roboime/SSL_Electronic_Boards/Kicker_Module_2016/Project Outputs for kicker_driver00/BOM1.xls

Name | Description | Designator | Quantity | LibRef | Manufacturer 1 | Manufacturer Part Number 1 | Manufacturer Lifecycle 1 | Supplier 1 | Supplier Part Number 1 | Supplier Unit Price 1 | Supplier Subtotal 1 | Supplier Currency 1 | Supplier Order Qty 1 | Supplier Stock 1 | Supplier Subtotal per Board 1
CGA9P4X7T2W105M250KE | 1µF 450V Ceramic Capacitor X7T 2220 (5750 Metric) 0.224" L x 0.197" W (5.70mm x 5.00mm) | BoostC1 | 1.0 | Cap 1UF 2220 450V | TDK Corporation | CGA9P4X7T2W105M250KE | Manual Solution | Digi-Key | 445-7998-1-ND | 3.08 | 3.08 | USD | 1.0 | 16579.0 | 3.08
MURS360BT3G | Surface Mount Ultrafast Power Rectifier, 2-Pin SMB, Pb-Free, Tape and Reel | BoostD1, P4D1, P5D1 | 3.0 | CMP-0902-00327-1 | Falha catastrófica | MURS360BT3G | Manual Solution | Digi-Key | MURS360BT3GOSCT-ND | 0.41 | 1.23 | USD | 3.0 | 64572.0 | 1.23
GRM155R71H102KA01D | 1000pF 50V Ceramic Capacitor X7R 0402 (1005 Metric) 0.039" L x 0.020" W (1.00mm x 0.50mm) | ConC1 | 1.0 | Cap 1nF 0402 | Falha catastrófica | GRM155R71H102KA01D | Manual Solution | Digi-Key | 490-1303-1-ND | 0.1 | 0.1 | USD | 1.0 | 5219427.0 | 0.1
MC34063ACD | Buck, Boost Switching Regulator IC Positive or Negative Adjustable 1.25V 1 Output 1.5A (Switch) 8-SOIC (0.154", 3.90mm Width) | ConIC1 | 1.0 | MC34063ACD | STMicroelectronics | MC34063ACD-TR | Manual Solution | Digi-Key | 497-7850-1-ND | 0.57 | 0.57 | USD | 1.0 | 35351.0 | 0.57
CRA2512-FZ-R100ELF | RES SMD 0.1 OHM 1% 3W 2512 | ConR1 | 1.0 | RES 0R1 2512 | Falha catastrófica | CRA2512-FZ-R100ELF | Manual Solution | Digi-Key | CRA2512-FZ-R100ELFCT-ND | 0.6 | 0.6 | USD | 1.0 | 60102.0 | 0.6
RC1206JR-073K3L | RES SMD 3.3K OHM 5% 1/4W 1206 | ConR2 | 1.0 | RES 3.3K 1206 |  |  |  |  |  | 0.0 | 0.0 |  | 0.0 | 0.0 | 0.0
RC1206FR-07470KL | RES SMD 470K OHM 1% 1/4W 1206 | ConR3 | 1.0 | RES 470K 1206 |  |  |  |  |  | 0.0 | 0.0 |  | 0.0 | 0.0 | 0.0
RC0402JR-0747RL | RES SMD 47 OHM 5% 1/16W 0402 | ConR4 | 1.0 | RES 47 0402 |  |  |  |  |  | 0.0 | 0.0 |  | 0.0 | 0.0 | 0.0
RC0402JR-071KL | RES SMD 1K OHM 5% 1/16W 0402 | ConR5 | 1.0 | RES 1K 0402 |  |  |  |  |  | 0.0 | 0.0 |  | 0.0 | 0.0 | 0.0
C4532X7R2E474K230KA | 0.47µF 250V Ceramic Capacitor X7R 1812 (4532 Metric) 0.177" L x 0.126" W (4.50mm x 3.20mm) | KickC1, KickC2 | 2.0 | Cap 470nF 250V 1812 | TDK Corporation | C4532X7R2E474K230KA | Manual Solution | Digi-Key | 445-2299-1-ND | 0.88 | 1.76 | USD | 2.0 | 47529.0 | 1.76
GRM155R71C104KA88D | 0.10µF 16V Ceramic Capacitor X7R 0402 (1005 Metric) 0.039" L x 0.020" W (1.00mm x 0.50mm) | KickC3, SwC1 | 2.0 | Cap 100nF 0402 | Murata Electronics North America | GRM155R71C104KA88D | Manual Solution | Digi-Key | 490-3261-1-ND | 0.012 | 0.12 | USD | 10.0 | 22343893.0 | 0.024
T491A475M025AT | 4.7µF Molded Tantalum Capacitors 25V 1206 (3216 Metric) 6 Ohm 0.126" L x 0.063" W (3.20mm x 1.60mm) | KickC4, SwC2 | 2.0 | Cap Tant 4,7UF 1206 | Kemet | T491A475M025AT | Manual Solution | Digi-Key | 399-4630-1-ND | 0.43 | 0.86 | USD | 2.0 | 215543.0 | 0.86
IR4427STRPBF | IC DRIVER DUAL LOW SIDE 8SOIC | KickIC1, SwIC1 | 2.0 | IR4427 | Infineon Technologies | IR4427STRPBF | Manual Solution | Digi-Key | IR4427SPBFCT-ND | 1.36 | 2.72 | USD | 2.0 | 41582.0 | 2.72
IRFP4768PbF | MOSFET N-CH 250V 93A TO-247AC | KickQ1, KickQ2 | 2.0 | IRG4PC50FD |  |  |  |  |  | 0.0 | 0.0 |  | 0.0 | 0.0 | 0.0
RC0402JR-0710RL | RES SMD 10 OHM 5% 1/16W 0402 | KickR1, KickR3, SwR1, SwR3 | 4.0 | RES 10 0402 | Yageo | RC0402JR-0710RL | Manual Solution | Digi-Key | 311-10JRCT-ND | 0.012 | 0.12 | USD | 10.0 | 542048.0 | 0.048
PF1206FRF070R02L | RES SMD 0.02 OHM 1% 1/4W 1206 | KickR2, KickR4, SwR2 | 3.0 | RES 0R02 1206 | Yageo | PF1206FRF070R02L | Manual Solution | Digi-Key | 311-0.02AJCT-ND | 0.52 | 1.56 | USD | 3.0 | 94479.0 | 1.56
Header 12 | Header, 12-Pin | P1, P2 | 2.0 | Header 12 |  |  |  |  |  | 0.0 | 0.0 |  | 0.0 | 0.0 | 0.0
EEE-FK1C681GP | Aluminum Electrolytic Capacitors - SMD Al Lytic Cap SMT FK Series 105C | P2C1 | 1.0 | CAP AL 680UF/16V | Panasonic Electronic Components | EEE-FK1C681GP | Manual Solution | Digi-Key | PCE4316CT-ND | 1.2 | 1.2 | USD | 1.0 | 2997.0 | 1.2
MF-MSMF250/16X-2 | PTC RESETTABLE | P2F1 | 1.0 | MF-MSMF250/16X | Bourns Inc. | MF-MSMF250/16X-2 | Manual Solution | Digi-Key | MF-MSMF250/16X-2CT-ND | 0.77 | 0.77 | USD | 1.0 | 27980.0 | 0.77
OSTTA024163 | 2 Position Wire to Board Terminal Block Horizontal with Board 0.200" (5.08mm) Through Hole | P3, P4, P5 | 3.0 | Term Block 2P |  |  |  |  |  | 0.0 | 0.0 |  | 0.0 | 0.0 | 0.0
SRF1280-100M | Shielded 2 Coil Inductor Array 40µH Inductance - Connected in Series 10µH Inductance - Connected in Parallel 24.1 mOhm Max DC Resistance (DCR) - Parallel 6.04A Nonstandard | SRF1280 | 1.0 | SRF1280-100M | Falha catastrófica | SRF1280-100M | Manual Solution | Digi-Key | SRF1280-100MCT-ND | 1.5 | 1.5 | USD | 1.0 | 617.0 | 1.5
C1206C474K5NACTU | 0.47µF 50V Ceramic Capacitor X8L 1206 (3216 Metric) 0.126" L x 0.063" W (3.20mm x 1.60mm) | SwC3 | 1.0 | Cap 470nF 50V 1206 | Kemet | C1206C474K5NACTU | Manual Solution | Digi-Key | 399-5732-1-ND | 0.34 | 0.34 | USD | 1.0 | 125040.0 | 0.34
MMSZ18T1G | Zener Voltage Regulator, 500 mW, 2-Pin SOD-123, Pb-Free, Tape and Reel | SwD1 | 1.0 | CMP-1060-00279-1 | ON Semiconductor | SZMMSZ18T1G | Manual Solution | Digi-Key | SZMMSZ18T1GOSCT-ND | 0.38 | 0.38 | USD | 1.0 | 2900.0 | 0.38
SUM45N25-58-E3 | MOSFET N-CH 250V 45A D2PAK | SwQ1 | 1.0 | SUM45N25 | Vishay Siliconix | SUM45N25-58-E3 | Manual Solution | Digi-Key | SUM45N25-58-E3CT-ND | 3.27 | 3.27 | USD | 1.0 | 6484.0 | 3.27
