roboime/SSL_Electronic_Boards/Motor_Driver_2018/Project Outputs for Motor_Driver_2018/Motor_Driver_2018PCB.xls

Comment | Description | Designator | Footprint | LibRef | Quantity
100nF | CAP CER 0.1UF 50V 10% X7R 0402 | C1, C6 | 0402-CAP | CC0402-100nF-50v-A.3 | 2.0
33nF | CAP CER 0.033UF 25V 10% X7R 0402 | C2, C5 | 0402-CAP | CC0402-33nF-5 | 2.0
220nF | CAP CER 0.22UF 16V 10% X7R 0402 | C3, C4 | 0402-CAP | CC0402-220nF-5 | 2.0
10uF | CAP TANT 10uF 10% 16V CASE A ESR = 3 Ohm @ 100 kHz | C7 | 1206_CAP_TANT | CT3216-10uF-1 | 1.0
22032041 | CONN HEADER 4POS .100 VERT TIN | CON-MC1, CON-MC2 | 04X01_CONECTOR_MALE | 04x01_Conector_Male-SCH | 2.0
PWD13F60 | High Voltage Full Bridge | IC? | QFN50P1000X1300X85_HS-61N | PWD13F60_1-01.A.8 | 1.0
