roboime/SSL_Electronic_Boards/Kicker_Module_2018/Project Outputs for Kicker_Module_2018/Kicker2018_PCB.xls

Comment | Description | Designator | Footprint | LibRef | Quantity
BAS40 Diode |  | BAS40, D6 | DIODE SOD-523 | BAS40 Diode | 2.0
10uF | CAP CER 10UF 16V X5R 0603 | C1, C2, C3 | CAPC0603(1608)55_L | C0603-10uF-16V-1 | 3.0
100pF | CAP CER 100PF 50V NP0 0603 | C4 | CAPC0603(1608)55_L | CC0603--1 | 1.0
100uF | CAP TANT 100uF 25V 20% ESR = 30mOhm @ 100 kHz | C5, C7, C9 | 7343-CAPPOL | CT2917-100uF-1 | 3.0
22uF |  | C6 | CAP ALUM 22UF 250V | CAP ALUM 22UF 250V | 1.0
180pF | CAP CER 180PF 50V NP0 0805 | C8 | 0805-CAP | CC0805-180pF-2 | 1.0
CHARGE_ENABLE | Single-Pole, Single-Throw Switch | CE | TACTILE SWITCH | SW-SPST | 1.0
OSTTA024163 | 2 Position Wire to Board Terminal Block Horizontal with Board 0.200" (5.08mm) Through Hole | CON_CAP, CON_CHIP_KICK, CON_KICK | TERM BLOCK 2P | Term Block 2P | 3.0
ES3J |  | D1, D2, D3 | DIODE | ES3J | 3.0
PMEG30 | DIODE SCHOTTKY 30V 5A SOD128 | D4 | PCBComponent | PMEG3050EP,115-01.A.5 | 1.0
GATE DRIVER | IC DRIVER DUAL LOW SIDE 8-SOIC | IR4427 | IR4427 | IR4427 | 1.0
100uH | Fixed Inductors 100uH 0.86A SMT | L1 | INDUCTOR | Inductor | 1.0
DA2034 Transformer |  | L2 | DA2034 TRANSFORMER | DA2034 Transformer | 1.0
Flyback Regulator |  | LT3750 | LT3750 | LT3750 | 1.0
Switching Voltage Regulator | Switching Voltage Regulator | MC34063 | MC34063 | MC34063 | 1.0
Header 12 | Header, 12-Pin | P1, P2 | HDR1X12 | Header 12 | 2.0
CSD1854 | MOSFET N-CH 60V 100A 8VSON | Q1 | PCBComponent | CSD18540Q5BT-1 | 1.0
IRG4PC50FD | IGBT Transistors 600V FAST 1-8 KHZ COPACK IGBT | Q2, Q3 | IRG4PC50FD | IRG4PC50FD | 2.0
100K | RES 100K OHM 1/10W 1% 0402 SMD 1 | R1 | 0402-RES-HD | R0402-100K-11 | 1.0
33K | RES 33K OHM 1/10W 1% 0402 SMD | R2 | 0402-RES-HD | R0402-33K-7 | 1.0
42K2 | RES 42.2K OHM 1/10W 1% 0402 SMD | R3 | 0402-RES-HD | RESISTOR | 1.0
2K2 | RES 2.2K OHM 1/10W 1% 0402 SMD | R4 | 0402-RES-HD | R0402-2K2-5 | 1.0
15m | Resistor | R5 | RES1206 | Res2 | 1.0
10R | RES 10 OHM 1/10W 1% 0402 SMD | R6, R7 | 0402-RES-HD | R0402-10R-6 | 2.0
1R | RES SMD 1 OHM 1% 1/8W 0805 | R8 | 0805-RES | R0805-1R-1%-1 | 1.0
160R | RES 160 OHM 1/8W .5% 0805 SMD | R9 | 0805-RES | R0805-160R-5 | 1.0
1K | RES 1K OHM 1/10W 1% 0402 SMD | R10, R12 | 0402-RES-HD | R0402-1K-A.9 | 2.0
11K1 | RES 11.1 KOHM 1/16W 0.1% 0402 SMD | R11 | 0402-RES-HD | R0402-11K1-1 | 1.0
KICK | Single-Pole, Single-Throw Switch | S1 | TACTILE SWITCH | SW-SPST | 1.0
