roboime/SSL_Electronic_Boards/Mother_Board_2018/Project Outputs for Mother_Board_SSL2018/Mother_board_SSL2018.xls

Comment | Description | Designator | Footprint | LibRef | Quantity
MOTOR 0 | CONN HEADER 6POS .100 VERT GOLD | 06x01_Conector_Male_M0 | 06x01_Conector_Male | 06x01_Conector_Male | 1.0
MOTOR 3 | CONN HEADER 6POS .100 VERT GOLD | 06x01_Conector_Male_M1 | 06x01_Conector_Male | 06x01_Conector_Male | 1.0
MOTOR 1 | CONN HEADER 6POS .100 VERT GOLD | 06x01_Conector_Male_M2 | 06x01_Conector_Male | 06x01_Conector_Male | 1.0
MOTOR 2 | CONN HEADER 6POS .100 VERT GOLD | 06x01_Conector_Male_M3 | 06x01_Conector_Male | 06x01_Conector_Male | 1.0
XT60 | XT60 PRT-10474 | BAT | BATTERY_CONECTO-PCB | BATTERY_CONNECTOR | 1.0
100nF | CAP CER 0.1UF 50V 10% X7R 0402, CAP CER 0.1UF 10V 20% X5R 0402 | C1, C5, C6, MC_C1, MC_C2, MC_C3, MC_C4, MC_C5, NRF_C1 | 0402-CAP | CC0402-100nF-50v-A.3, CC0402-100nF-A.12 | 9.0
22uF | CAP CER 22UF 6.3V 20% X5R 1206 | C2, C3 | 1206-CAP | CC1206-22uF-6.3V-1 | 2.0
10uF | CAP CER 10UF 50V 20% X5R 1210 | C4 | 1210-CAP | CC1210-10uF-6 | 1.0
1uF | CAP CER 1UF 6.3V 10% X5R 0402 | C7 | 0402-CAP | CC0402-1uF-5 | 1.0
CAP_TANQUE | Aluminum Electrolytic Capacitors - SMD Al Lytic Cap SMT FK Series 105C | CD, CM1_M2, CM1_M3 | EEE-FK1C681GP | CAP AL 680UF/16V | 3.0
CAP-TANQUE | Aluminum Electrolytic Capacitors - SMD Al Lytic Cap SMT FK Series 105C | CM1_M0, CM1_M1 | EEE-FK1C681GP | CAP AL 680UF/16V | 2.0
DRIBLE | CONN HEADER 2POS .100 VERT GOLD | CON_DRIBLE | 02x01_Conector_Male | 02x01_Conector_Male | 1.0
MF-MSMF | PTC RESETTABLE .30A 30V 1812 | DF, FM_M0, FM_M1, FM_M2, FM_M3 | RESC4632X16N | MF-MSMF250/16X-01.A.1 | 5.0
SFH11-PBPC-D25-ST-BK | 50 Position Header Connector 0.100" (2.54mm) Through Hole Gold | DISCO_P1, DISCO_P2 | 25x02_Conector_Female | 25x02_Conector_Female | 2.0
HDSP-F513 | 7 segments display | Display | New footprint 1 | HDSP-F513-01.A.2 | 1.0
PPPC041LFBN-RC | 4 Position Header Connector 0.100" (2.54mm) Through Hole Gold | DRIBLE-MC, DRIBLE-MOTOR | 04x01_Conector_Female - duplicate | 04x01_Conector_Female-SCH | 2.0
TPS5632 | IC REG BUCK ADJ 3A SYNC 6SOT | IC1 | SOT95P280X110-6N | TPS563200DDCT-01.A.2 | 1.0
MPU-9250 | IMU ACCEL/GYRO/MAG I2C/SPI 24QFN | IC3 | MPU-9250 | MPU-9250-1 | 1.0
STMPE811 | IC TSC I/O EXPAND 8B 16QFN | IC4 | QFN16_N | STMPE811QTR-6 | 1.0
SWITCH TACTILE 6 x 3.5 x 4.3 mm | GRAYHILL TACT,GW,6X3.5,1800T&R,LF Eight, 160g Operating Force, Gull Wing, RoHS Compliant | ID | PCBComponent | 95C04A3GWRT.-1 | 1.0
INA169 | IC CURRENT MONITOR 0.5% SOT23-5 | INA169, INA169_M0, INA169_M1, INA169_M2, INA169_M3 | SOT95P280X125-5N | INA169NA-01.A.1 | 5.0
JS202011SCQN | SWITCH SLIDE DPDT 300MA 6V | KICK | SOP250P750X350-6N | JS202011SCQN-1 | 1.0
CLF7045T | FIXED IND 4.7UH 4.1A 20 MOHM SMD | L1 | CLF7045T | CLF7045T-4R7N-H-2 | 1.0
LD1117S33CTR | Fixed Low Drop Positive Voltage Regulator, 3.3V, 4-Pin SOT-223, Tape and Reel | LD1117 | SOT-223_N | CMP-0244-00307-1 | 1.0
0022112022 | CONN HEADER 2POS .100 VERT GOLD | LED1, LED2, SEN1, SEN2 | 02x01_Conector_Male | 02x01_Conector_Male | 4.0
LED | LED 5MM PTH | LED_BALL_L, LED_BALL_R, LED_COM_L, LED_COM_R, LED_GRE_L, LED_GRE_R, LED_ORA_L, LED_ORA_R | LED-5MM-PCB | LED-5MM-3 | 8.0
PPPC041LFBN-RC | 4 Position Header Connector 0.100" (2.54mm) Through Hole Gold | M0-MC, M0-MOTOR, M1-MC, M1-MOTOR, M2-MC, M2-MOTOR, M3-MC, M3-MOTOR | 04x01_Conector_Female | 04x01_Conector_Female-SCH | 8.0
4K7 | Resistor | MC_R1, MC_R2 | 0402 | Res1 | 2.0
PPPC042LFBN-RC | 8 Position Header Connector 0.100" (2.54mm) Through Hole Gold | NRF24 | 04x02_Conector_Female | 04x02_Conector_Female | 1.0
Header 12 | Header, 12-Pin | P1_Chute, P2_Chute | HDR1X12 | Header 12 | 2.0
33K | RES 33K OHM 1/10W 1% 0402 SMD | R1 | 0402-RES-HD | R0402-33K-7 | 1.0
10K | RES 10K OHM 1/10W 1% 0402 SMD | R2, R37 | 0402-RES-HD | R0402-10K-10, R0402-10K-11 | 2.0
330R | RES 330R OHM 1/10W 1% 0402 SMD, RES 330 OHM 1/10W 1% 0402 SMD | R3, R29, R30, R31, R32, R33, R34, R35, R36, RS1, RS2 | 0402-RES-HD | R0402-10K-10, R0402-330R-7 | 11.0
100R | RES 100R OHM 1/10W 1% 0402 SMD, RES 100 OHM 1/10W 1% 0402 SMD | R4, RL1, RL2 | 0402-RES-HD | R0402-33K-7, R0402-100R-5 | 3.0
1K | RES 1K OHM 1/10W 1% 0402 SMD | R10_M0, R10_M1, R10_M2, R10_M3, R_D | 0402-RES-HD | R0402-1K-A.9 | 5.0
0R02 | RES .02 OHM 2W 1% 2512 SMD | R11_M0, R11_M1, R11_M2, R11_M3, RD1 | 2512-RES-HD | R2512-0R02-4 | 5.0
2908-05WB-MG | CONN MICRO SD CARD PUSH-PUSH R/A | SD1 | New footprint 1 | 2908-05WB-MG-01.A.1 | 1.0
R1966A | SWITCH ROCKER SPST 15A 125V | SW | R1966AB-PCB | Rocker Switch | 1.0
