roboime/SSL_Electronic_Boards/Motor_Driver_2016/Project Outputs for Motor_Driver/Motor_Driver_PCB.xls

Comment | Description | Designator | Footprint | LibRef | Quantity
100nF | CAP CER 100PF 50V 1% NP0 0402 | C1_MAHB, C1_MBHB | 0402-CAP | CC0402-100pF-A.2 | 2.0
4,7UF | Tantalum Capacitors - Solid SMD 10uF 35V 10% L ESR | C2_MAHB, C2_MBHB | PCBComponent | TPSD106K035R0300-01.A.1 | 2.0
22032041 | CONN HEADER 4POS .100 VERT TIN | CON-MC, CON-MOTOR | 04x01_Conector_Male | 04x01_Conector_Male-SCH | 2.0
IR4427STRPBF | IC DRIVER DUAL LOW SIDE 8-DIP | IR4427_MAHB, IR4427_MBHB | IR4427-PCB | IR4427 | 2.0
IRF7389TRPBF | MOSFET N/P-CH 30V 8-SOIC | IRF7389_MAHB, IRF7389_MBHB | IRF7389-PCB | IRF7389 | 2.0
330R | RES 330 OHM 1/10W 1% 0402 SMD | R1_MAHB, R1_MBHB, R2_MAHB, R2_MBHB | 0402-RES-HD | R0402-330R-7 | 4.0
10K | RES 10K OHM 1/10W 1% 0402 SMD | R3_MAHB, R3_MBHB | 0402-RES-HD | R0402-10K-10 | 2.0
10R | RES 10 OHM 1/10W 1% 0402 SMD | R4_MAHB, R4_MBHB, R5_MAHB, R5_MBHB | 0402-RES-HD | R0402-10R-6 | 4.0
