roboime/SSL_Electronic_Boards/Mother_Board_2018/Board_Mec.STEP

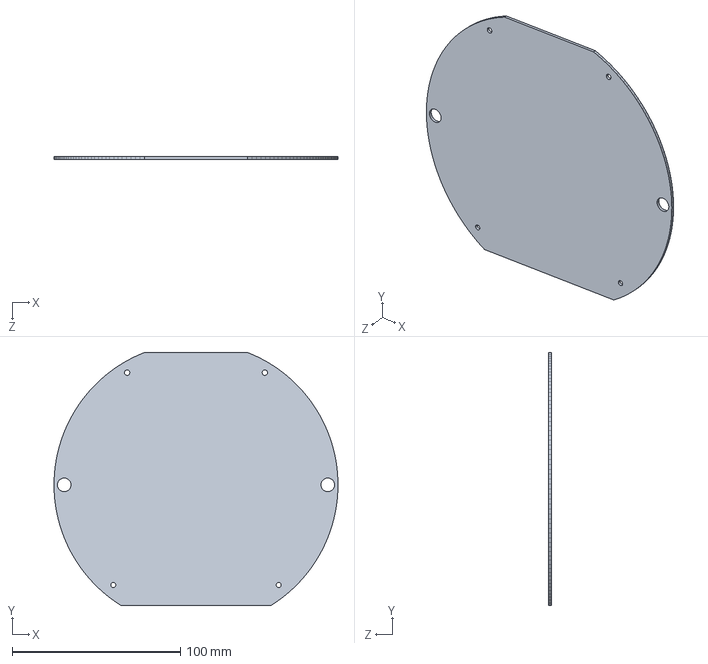
[picture p1: CAD file, 2018-05-14]
Mother_Board_2018/Board_Mec.STEP
169.0 x 150.6 x 1.59 mm
