roboime/SSL_Electronic_Boards/(list of files, cad)

Other CAD files:
Mother_Board_2018/Board (1).STEP
