roboime/SSL_Electronic_Boards/Kicker_Module_2018/PDNAnalyzer_Output/Kicker2018_PCB/simul_kick_2018/Results/vcomp2id.csv

vrefdes | id
VCOMP0 | 0
VCOMP1 | 1
VCOMP2 | 2
