roboime/SSL_Electronic_Boards/Mother_Board_2018/draftsman110618.pdf

## View from Top side (Scale 3:2)

# Line # 123456789

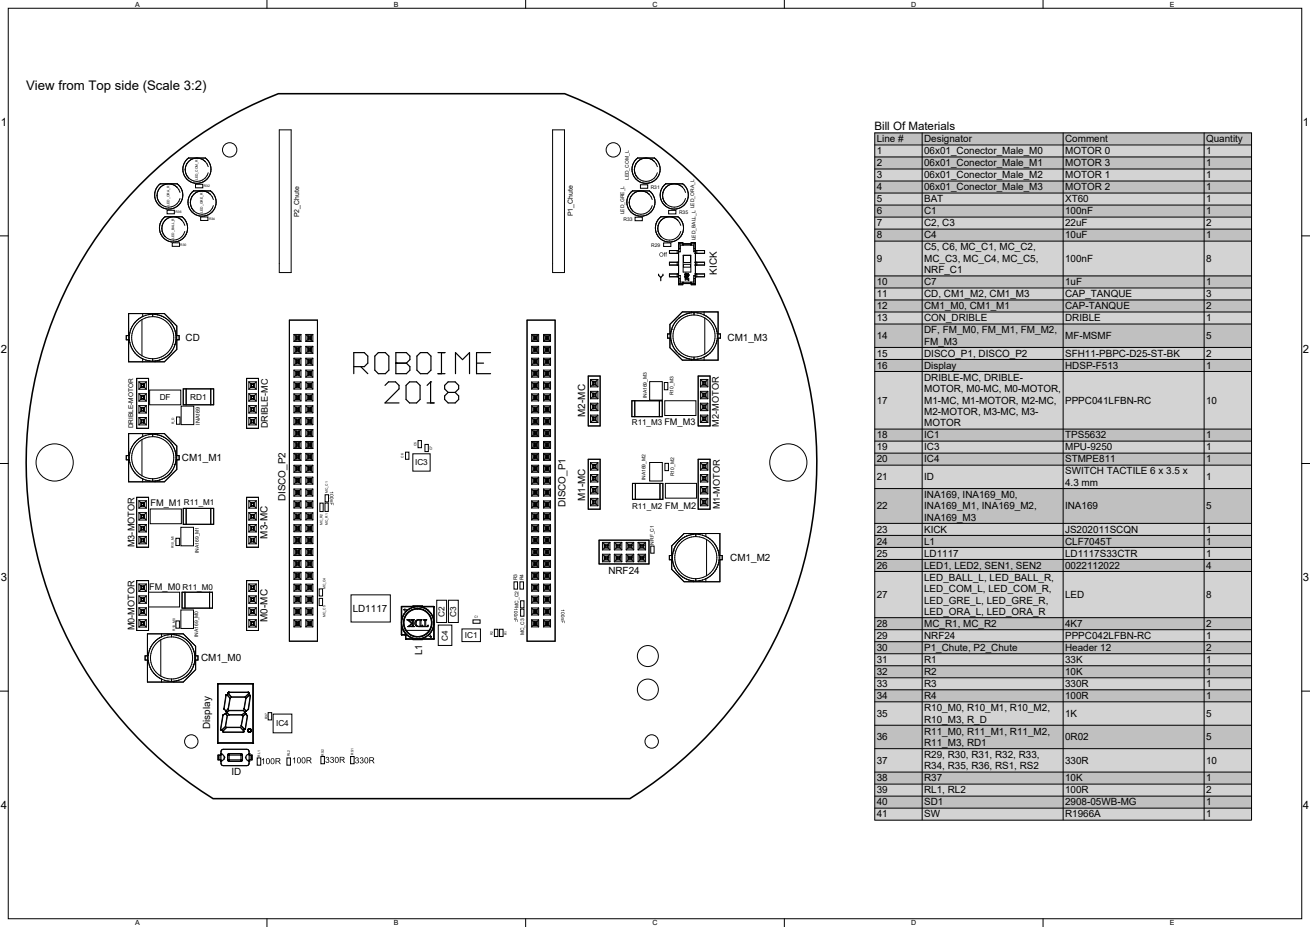
[picture p4: page 1]

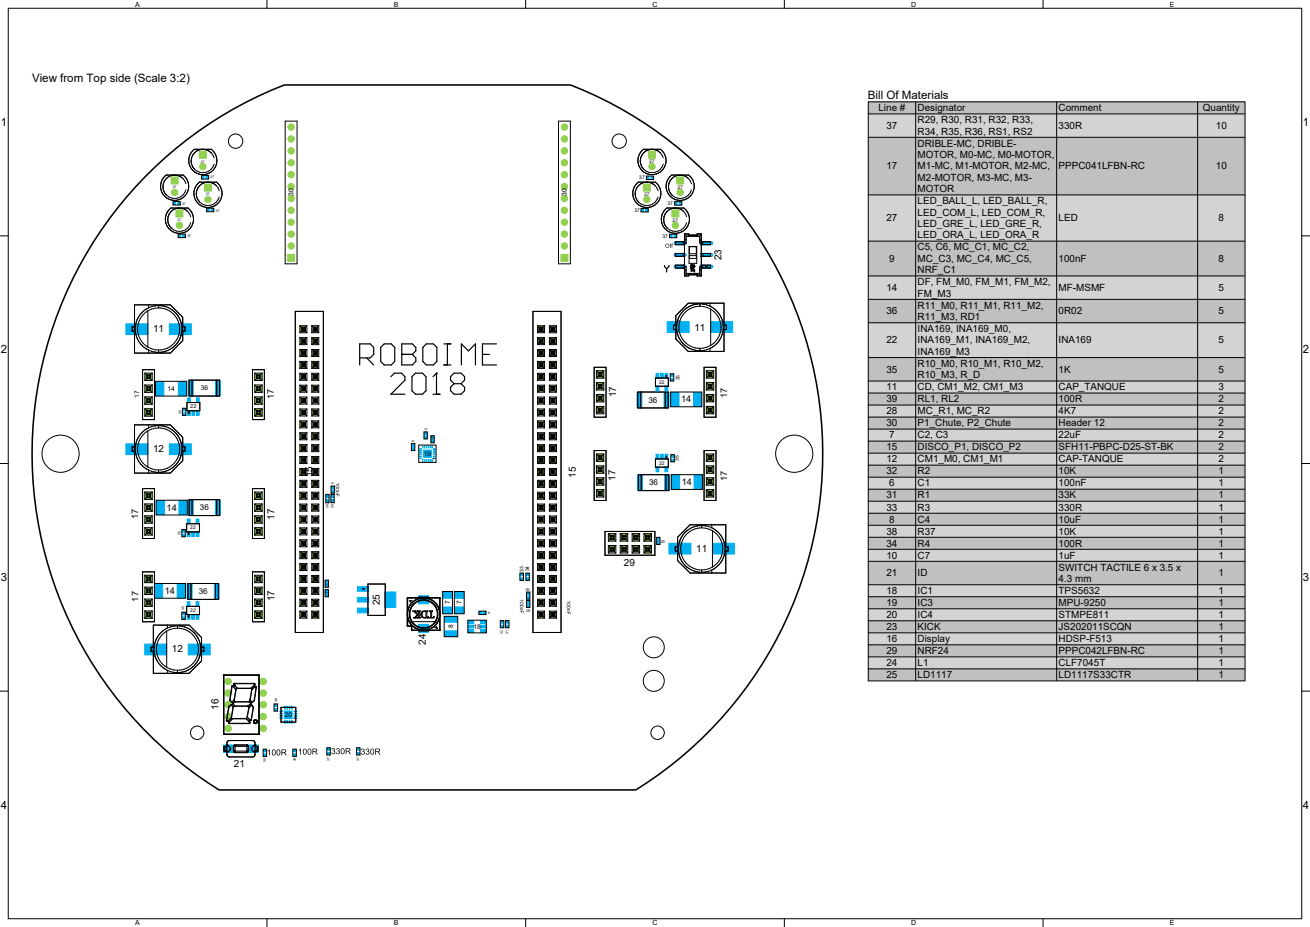
[picture p5: page 2]

View from Top side (Scale 3:2)

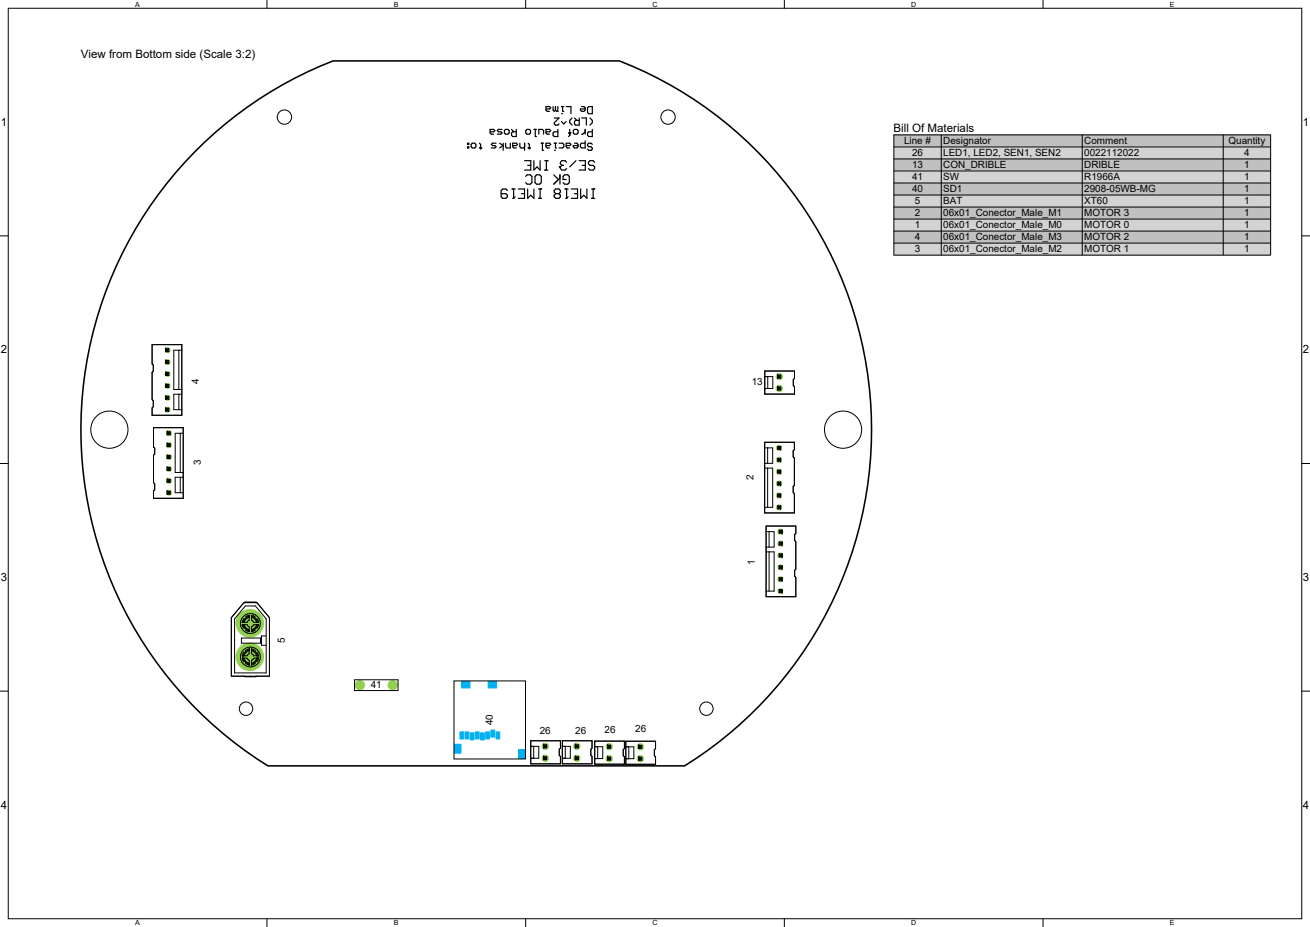
[picture p6: page 3]

View from Bottom side (Scale 3:2)

Bill Of Materials

Line # | Designator | Comment | Quantity
26 | LED1, LED2, SEN1, SEN2 | 0022112022 | 4
13 | CON_DRIBLE | DRIBLE | 1
41 | SW | R1966A | 1
40 | SD1 | 2908-05WB-MG | 1
5 | BAT | XT60 | 1
2 | 06x01_Conector_Male_M1 | MOTOR 3 | 1
1 | 06x01_Conector_Male_M0 | MOTOR 0 | 1
4 | 06x01_Conector_Male_M3 | MOTOR 2 | 1
3 | 06x01_Conector_Male_M2 | MOTOR 1 | 1
