roboime/SSL_Electronic_Boards/Mother_Board_2018/Mother_Board_SSL2018.pdf

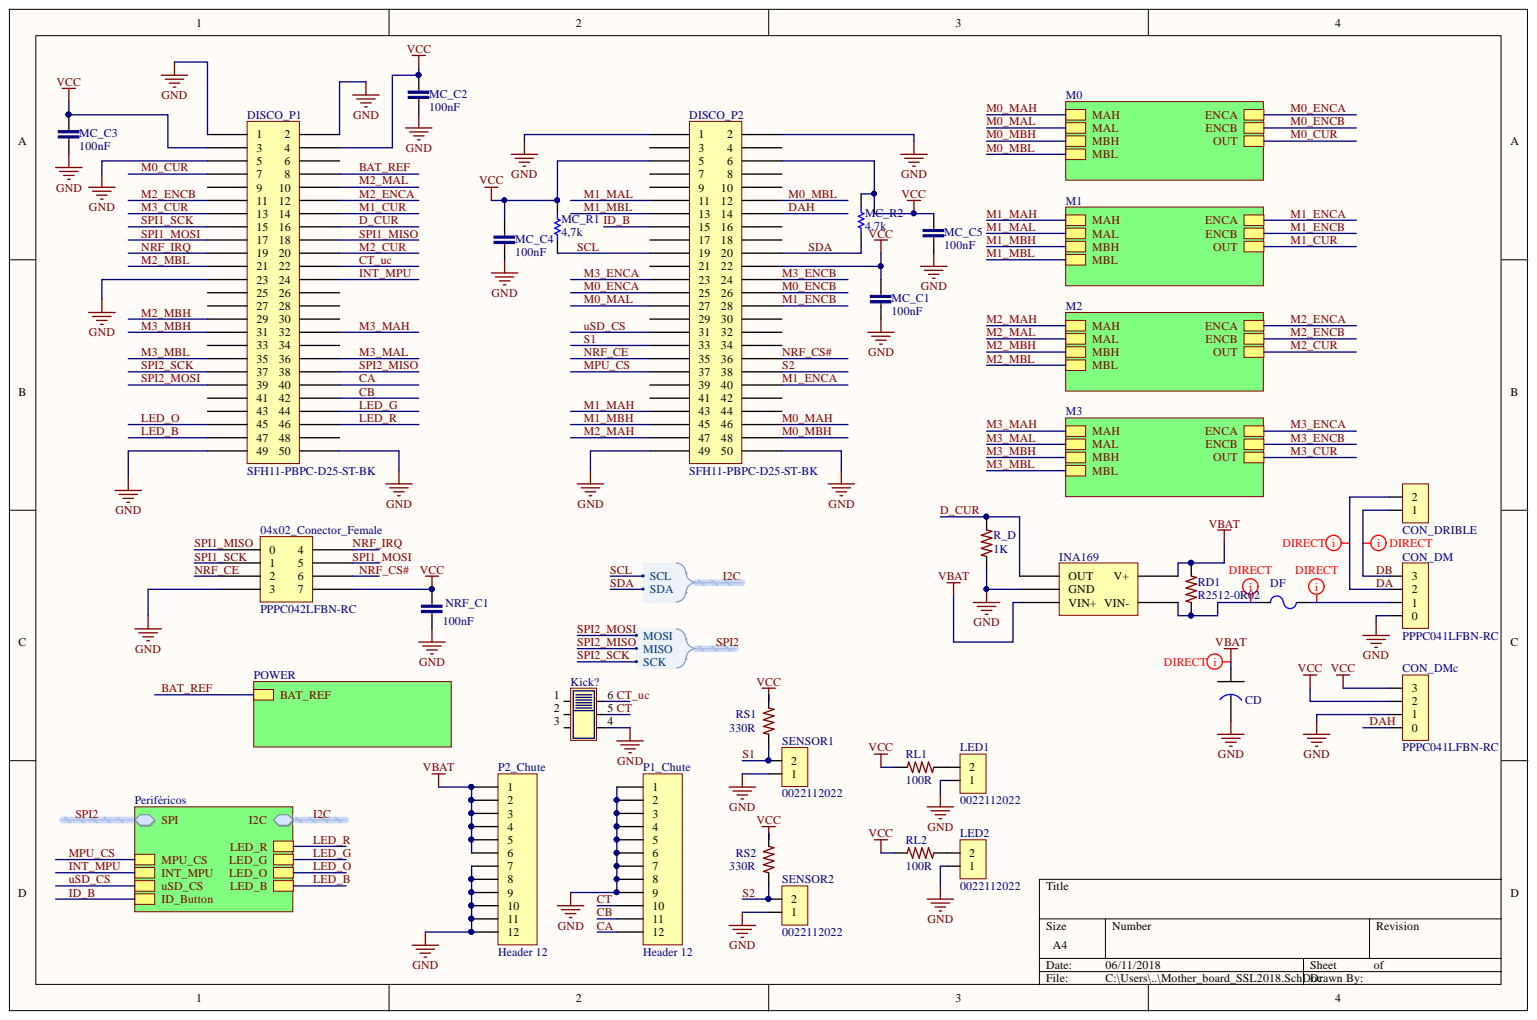
[picture p7: page 1]

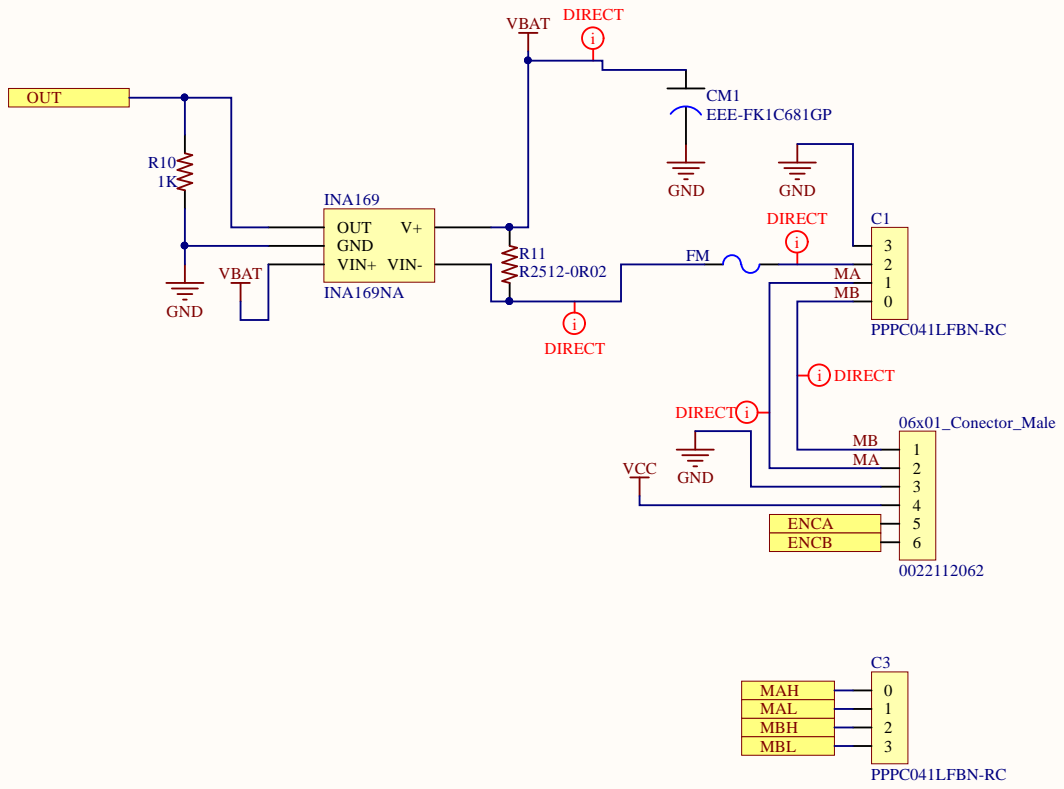
[picture p8: page 2]

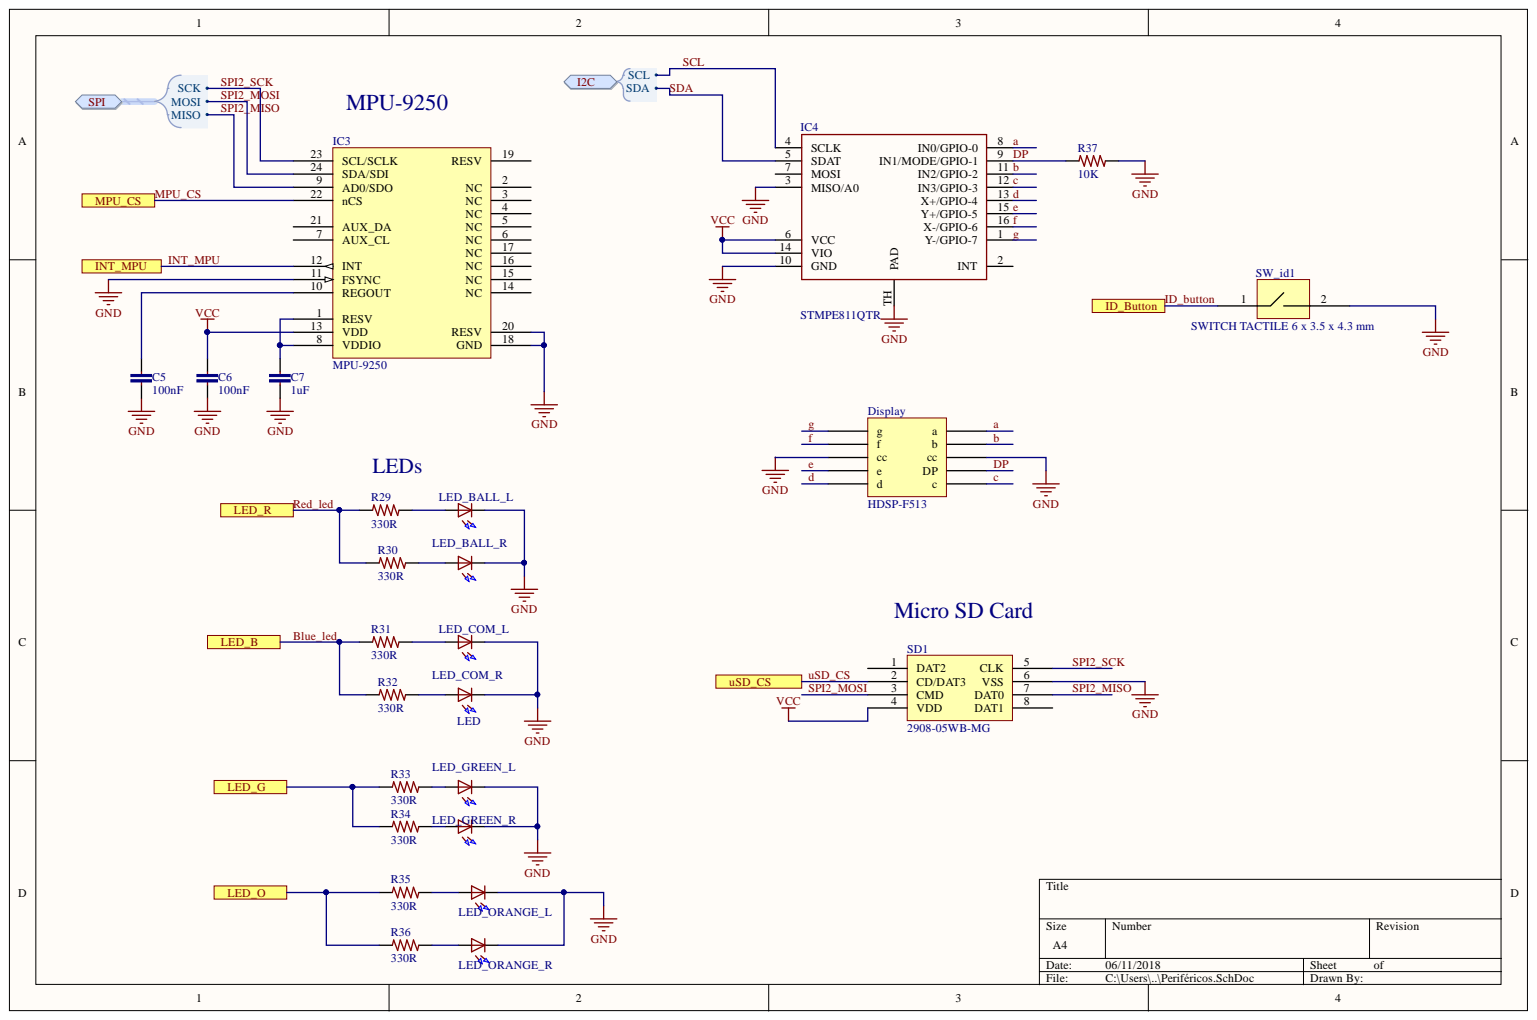
[picture p9: page 3]

RESV 1

VDDIO 8

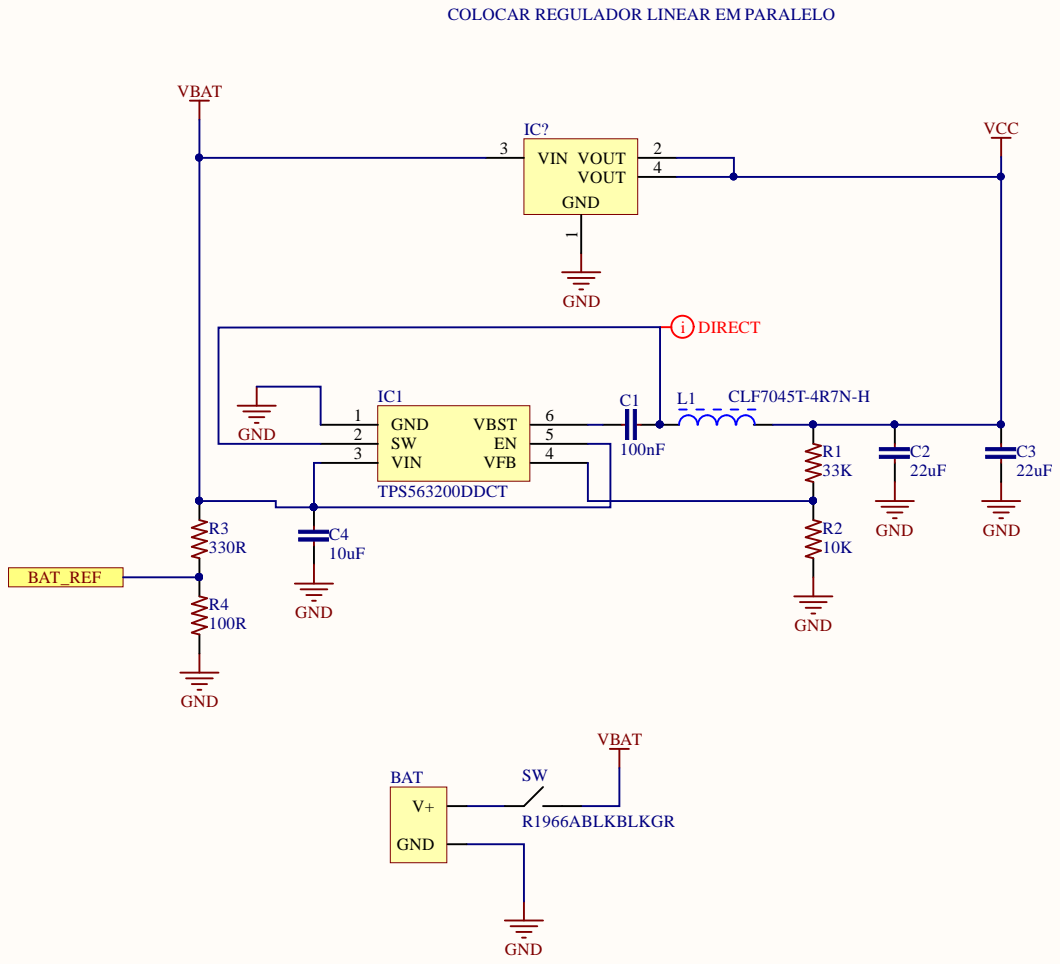
[picture p10: page 4]

COLOCAR REGULADOR LINEAR EM PARALELO
