roboime/SSL_Electronic_Boards/Mother_Board_2018/Mother_Board_SSL2018_layout.pdf

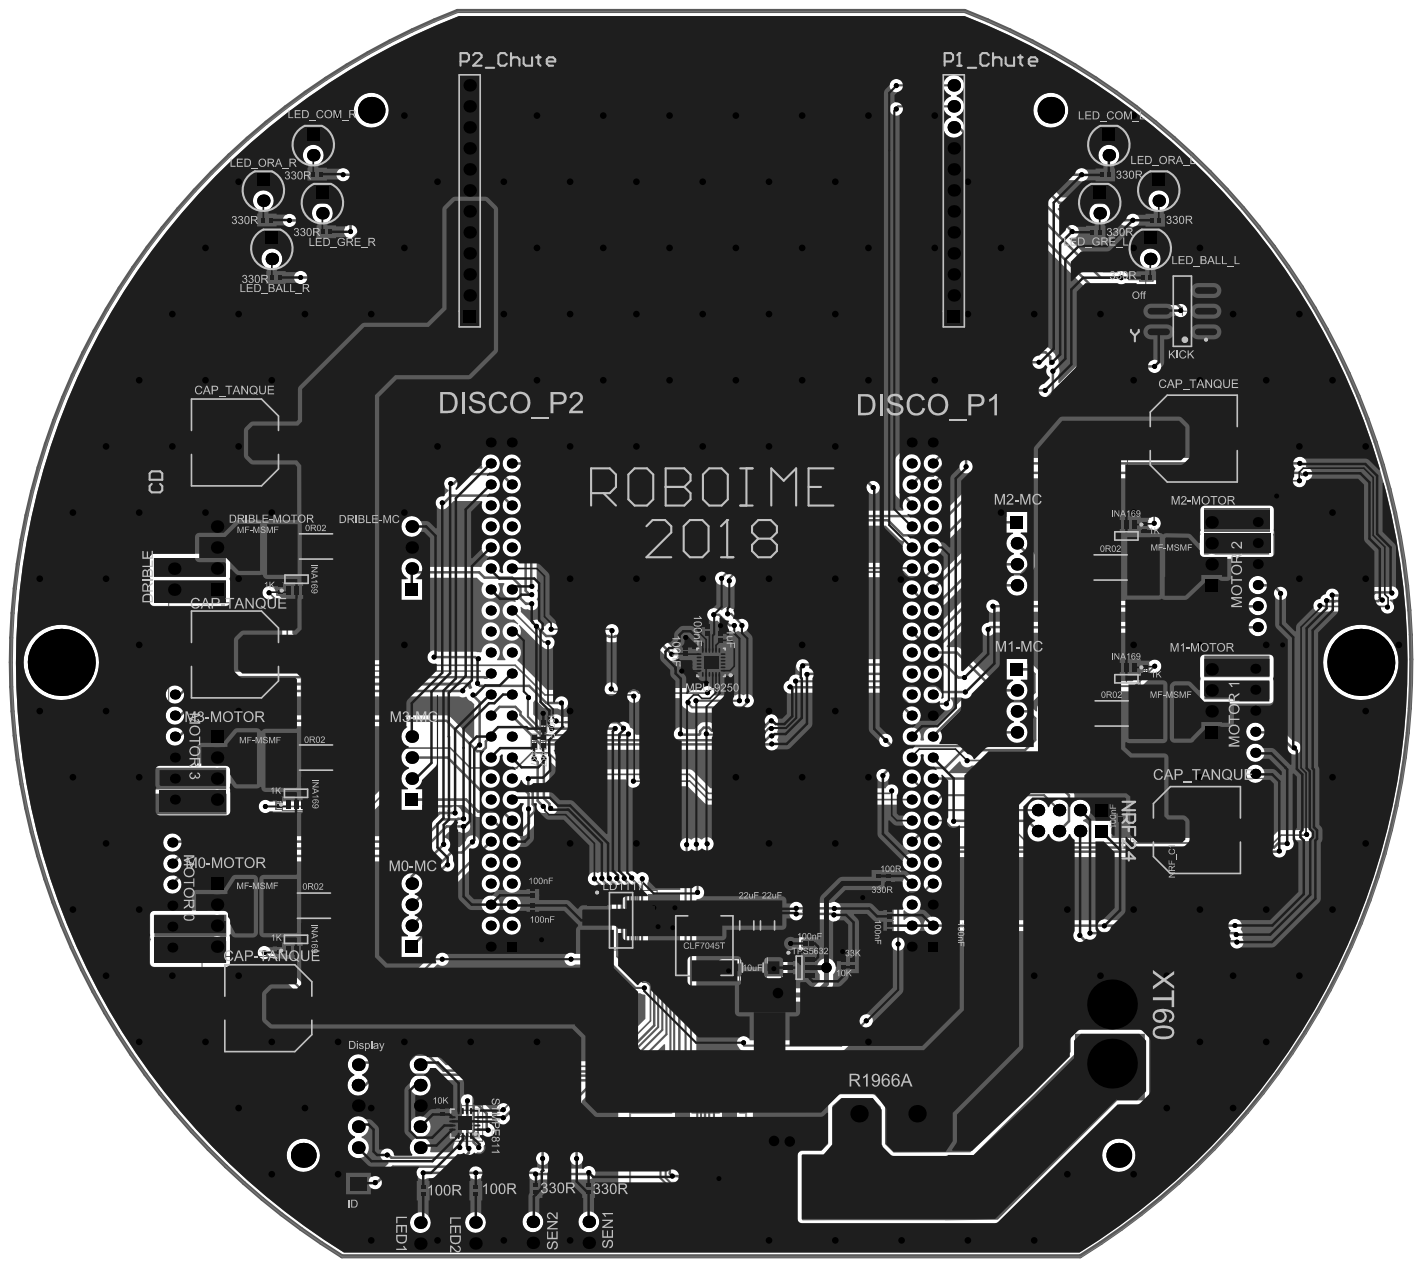
[picture p11: page 1]
