roboime/SSL_Electronic_Boards/Kicker_Module_2016/Draft1.asc

C1: cap; 10µ; V=25 Irms=8.06 Rser=0.00577565 Lser=0 mfg="KEMET" pn="C1210C106K3PAC" type="X5R"
C2: polcap; 56µ; V=25 Irms=235m Rser=0.44 Lser=0 mfg="Nichicon" pn="UPL1E560MPH" type="Al electrolytic"
C3: cap; 100pF
C4: cap; 10µ; V=25 Irms=8.06 Rser=0.00577565 Lser=0 mfg="KEMET" pn="C1210C106K3PAC" type="X5R"
C5: cap; 2.5mF
C6: polcap; 56µ; V=25 Irms=235m Rser=0.44 Lser=0 mfg="Nichicon" pn="UPL1E560MPH" type="Al electrolytic"
C7: polcap; 56µ; V=25 Irms=235m Rser=0.44 Lser=0 mfg="Nichicon" pn="UPL1E560MPH" type="Al electrolytic"
D1: diode
L1: ind2; 10µ
L2: ind2; 1000µ
M1: nmos; PHM21NQ15T
R1: res; 60.4K
R2: res; 43K
R3: res; 8m
R4: res; 2.49K
R5: res; 100K
U1: LT3750
V1: voltage; 6V
V2: voltage; PULSE(0 3.3V 0 0.1 0 50 0 1)
Named nets: 0
.tran 0 10 4 4
K1 L1 L2 1
