roboime/SSL_Electronic_Boards/(list of files, drawings)

Other design files:
Com_Board_2018/Capacitor.SchLib
Com_Board_2018/Com_Board_2018.PcbDoc
Com_Board_2018/Com_Board_2018.PrjPcb
Com_Board_2018/Com_board_2018.SchDoc
Kicker_Discharger_2018/Disch_PCB.PcbDoc
Kicker_Discharger_2018/Disch_Sch.SchDoc
Kicker_Discharger_2018/Kicker_Discharger_2018.PrjPcb
Kicker_Discharger_2018/KickerPCBLib.PcbLib
Kicker_Flyback_2018/Kicker_Flyback_2018.PrjPCB
Kicker_Flyback_2018/PCB Flyback.PcbDoc
Kicker_Flyback_2018/PcbLib1.PcbLib
Kicker_Flyback_2018/Sch Flyback.SchDoc
Kicker_Flyback_2018/Schlib1.SchLib
Kicker_Module_2016/kicker_driver00.PrjPcb
Kicker_Module_2016/PCB1.PcbDoc
Kicker_Module_2016/PcbLib1.PcbLib
Kicker_Module_2016/Schlib1.SchLib
Kicker_Module_2016/Sheet1.SchDoc
Kicker_Module_2018/Kicker2018.SchDoc
Kicker_Module_2018/Kicker2018_PCB.PcbDoc
Kicker_Module_2018/Kicker_Module_2018.PrjPcb
Kicker_Module_2018/KickerPCBLib.PcbLib
Kicker_Module_2018/KickerSchlib.SchLib
Mother_Board_2016/INA220.SchDoc
Mother_Board_2016/Mother_Board.PrjPcb
Mother_Board_2016/Mother_Board_Sch.SchDoc
Mother_Board_2016/MOTORES.SchDoc
Mother_Board_2016/POWER.SchDoc
Mother_Board_2016/Schlib1.SchLib
Mother_Board_2018/DRIBLE.SchDoc
Mother_Board_2018/INA220.SchDoc
Mother_Board_2018/Mother_board1.SchDoc
Mother_Board_2018/Mother_Board_SSL2018.PrjPcb
Mother_Board_2018/Mother_board_SSL2018.SchDoc
Mother_Board_2018/MOTORES.SchDoc
Mother_Board_2018/Periféricos.SchDoc
Mother_Board_2018/POWER.SchDoc
Mother_Board_2018/Schlib1.SchLib
Motor_Driver_2016/Half_Bridge.SchDoc
Motor_Driver_2016/Motor_Driver.PrjPcb
Motor_Driver_2016/Motor_Driver.SchDoc
Motor_Driver_2016/Motor_Driver_PCB.PcbDoc
Motor_Driver_2016/PcbLib1.PcbLib
Motor_Driver_2016/Schlib1.SchLib
Motor_Driver_2018/Motor_Driver_2018.PrjPcb
Motor_Driver_2018/Motor_Driver_2018PCB.PcbDoc
Motor_Driver_2018/Motor_Driver_2018Sch.SchDoc
Motor_Driver_2018/PcbLib1.PcbLib
Motor_Driver_2018/Schlib1.SchLib
