roboime/SSL_Electronic_Boards/(commit log)

2018-04-16 Novo repositorio para os circuitos eletronicos da RoboIME SSL
    [Disch_PCB.PcbDoc, Disch_Sch.SchDoc, Half_Bridge.SchDoc, INA220.SchDoc, Kicker2018.SchDoc, Kicker2018_PCB.PcbDoc, KickerPCBLib.PcbLib, KickerSchlib.SchLib]
2018-04-16 gitignore teste 1
    [Disch_Sch.SchDoc]
2018-04-21 mudanca de posicao dos conectores para o top layer e aumentos tanto na largura quanto no comprimento da placa, porem ainda esta menor que a placa antiga
2018-04-21 mudanca de posicao dos conectores para o top layer e aumentos tanto na largura quanto no comprimento da placa, porem ainda esta menor que a placa antiga (correcao do ultimo commit)
    [Kicker2018.SchDoc, Kicker2018_PCB.PcbDoc, Kicker_Module_2018.PrjPcb]
2018-04-22 Modificações no projeto da placa de chute
    Reposicionamento de alguns componentes para alargamento de algumas
    trilhas
    [Kicker2018.SchDoc, Kicker2018_PCB.PcbDoc]
2018-04-24 A partir do ultimo commit, fizemos novas mudancas nos clearences de planos de alta voltagem e as trilhas que dificultavam o caminho de corrente do GND do capactior de saida para os pinos de GND da pl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
    [Kicker2018.SchDoc, Kicker2018_PCB.PcbDoc]
2018-05-10 Adicao do botao de acionamento do chute na placa
    [Kicker2018.SchDoc, Kicker2018_PCB.PcbDoc, KickerPCBLib.PcbLib, KickerSchlib.SchLib, Kicker_Module_2018.PrjPcb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]
2018-05-11 adiciona botão e simulação PDN
    [Kicker2018.SchDoc, Kicker2018_PCB.PcbDoc, Kicker_Module_2018.PrjPcb, OdbCache.cfg, pins.csv, vcomp2id.csv, vias.csv, vpin2pin.csv]
2018-05-11 Novo modulo de motor adicionado ao projeto com pcb ja aprovado
    [Motor_Driver.SchDoc, Motor_Driver_2018.PrjPcb, Motor_Driver_2018PCB.PcbDoc, Motor_Driver_2018Sch.SchDoc, Motor_Driver_PCB.PcbDoc, PcbLib1.PcbLib, Schlib1.SchLib]
2018-05-11 add stitches into cap- plane
    [Kicker2018_PCB.PcbDoc, OdbCache.cfg, pins.csv, vcomp2id.csv, vias.csv, vpin2pin.csv, vpins.csv]
2018-05-14 Atualizacao dos projetos finais da placa de chute e modulo de motor
    [Kicker2018_PCB.GBL, Kicker2018_PCB.GBO, Kicker2018_PCB.GBP, Kicker2018_PCB.GBS, Kicker2018_PCB.GM1, Kicker2018_PCB.GTL, Kicker2018_PCB.GTO, Kicker2018_PCB.GTP]
2018-05-14 Adicionado ao repostirio o projeto da placa mae atualizado
    [Board (1).STEP, Board_Mec.STEP, INA220.SchDoc, MOTORES.SchDoc, Mother_Board_SSL2018.PrjPcb, Mother_board1.SchDoc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]
2018-05-14 correcao da versao do projeto da placa de chute
    [Kicker2018_PCB.PcbDoc, Kicker_Module_2018.PrjPcb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]
2018-05-27 atualizacao dos draftsman's para ajudar a soldar as placas
    [Mother_Board_SSL2018.PrjPcb, Motor_Driver_2018.PrjPcb]
2018-05-31 Rework no roteamento do Bottom para tentar eliminar as flutuacoes nos pinos de GND
    [Kicker2018_PCB.PcbDoc]
2018-05-31 Ajustes de posicionamento de componentes.
    [Kicker2018.SchDoc, Kicker2018_PCB.PcbDoc, Kicker_Module_2018.PrjPcb]
2018-06-01 finalizacao dos roteamentos
    [Kicker2018_PCB.PcbDoc]
2018-06-01 Adicao de dois diodos BAS40 para evitar altas tensões nos pinos da discovery e gerados stitches com furos de 0.3mm, ilhas de 0.6mm e grid de 1.5mm
    [Kicker2018.SchDoc, Kicker2018_PCB.PcbDoc, KickerPCBLib.PcbLib, KickerSchlib.SchLib]
2018-06-02 Correcao do modelo do diodo para o mesmo do Vault da IMBEL: BAS40-02V-V-G-08 e reducao no grid dos stitches para 1.2mm
    [Kicker2018.SchDoc, Kicker2018_PCB.PcbDoc, KickerPCBLib.PcbLib, KickerSchlib.SchLib]
2018-06-02 Corrige pcb, modifica PWD13F60 e nomeia headers
    [Motor_Driver_2018.PrjPcb, Motor_Driver_2018PCB.PcbDoc, Motor_Driver_2018Sch.SchDoc]
2018-06-02 Pequenos ajustes de trilhas
    [Kicker2018.SchDoc]
2018-06-03 Adicionado Tenting aos Via Stitchings
    [Kicker2018.SchDoc, Kicker2018_PCB.PcbDoc]
2018-06-04 top overlay e hole size
    [Kicker2018_PCB.PcbDoc]
2018-06-04 Finalizacao dos Overlays
    [Kicker2018_PCB.PcbDoc]
2018-06-04 Ultimos ajustes na placa de chute e adicionados tentings ao modulo de motor
    [Kicker2018.SchDoc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]
2018-06-05 Corrige Top Paste do módulo de motor
    [Motor_Driver_2018PCB.PcbDoc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]
2018-06-05 atualiza projeto do modulo de motor 2018
    [Motor_Driver_2018.PrjPcb]
2018-06-10 Atualização de documentação de montagem.
2018-06-10 modifica posicao dos conectores com motores e resistor dos leds IR
    [MOTORES.SchDoc, Mother_board_SSL2018.SchDoc]
2018-06-11 adiciona placa de comunicacao e pdf do draftsman da placa mae
    [Capacitor.SchLib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]
2018-06-11 modifica draftsman da placa de chute
2018-06-12 gera gerbers para fabricação
    [Com_Board_2018.PcbDoc, Com_Board_2018.PrjPcb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]
2019-02-21 creates BOM for each board
    [BOM1.xls, Kicker2018_PCB.xls, Kicker_Module_2018.PrjPcb, Mother_Board.PrjPcb, Mother_Board_SSL2018.PrjPcb, Mother_board_SSL2018.xls, Motor_Driver.PrjPcb, Motor_Driver_2018.PrjPcb]
2019-02-21 creates BOM for motor driver 2018
    [Motor_Driver_2018.PrjPcb, Motor_Driver_2018PCB.xls]
2019-08-22 organiza esquematico da placa mae
    [DRIBLE.SchDoc, MOTORES.SchDoc, Mother_board_SSL2018.SchDoc, POWER.SchDoc, Periféricos.SchDoc]
2019-10-15 melhorias na placa de chute 2018
    [Kicker2018.SchDoc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]
2019-10-16 corrige keepout
    [Kicker2018_PCB.GBL, Kicker2018_PCB.GBO, Kicker2018_PCB.GBP, Kicker2018_PCB.GBS, Kicker2018_PCB.GKO, Kicker2018_PCB.GTL, Kicker2018_PCB.GTO, Kicker2018_PCB.GTP]
2019-10-21 atualiza draftsman
    [Kicker2018.SchDoc, Kicker2018_PCB.PcbDoc, KickerPCBLib.PcbLib, KickerSchlib.SchLib, Kicker_Module_2018.PrjPcb]
2019-10-21 add draftsman em pdf
    [Kicker_Module_2018.PrjPcb]
2022-03-20 report errors
    text comments on .SchDoc to correct bad references to kicker board
    [Mother_board_SSL2018.SchDoc]
